lgarron/cubeflower/README.md

# Cubeflower

An elegant print-in-place cube box with a few useful features.

<https://www.youtube.com/shorts/GLqVjow3PYY>
Left and right lids of the cube flower folded mostly open, with the cube elevated in the middle

## Revisions

| Series | Features| Ease of printing |
|-|-|-|
| `v0.1.x` | Thicker walls, taller | Easy|
| `v0.2.x` | Thinner walls, minimal height | More challenging |

For now, consider printing [v0.1.6](https://github.com/lgarron/cubeflower/blob/v0.1.6/cube-box-v0.1.6.scad.3mf) before trying to print any `v0.2.x` version.

`v0.2.x` trades off carrying size for more reliance on material strength and printer tolerances. I personally get my best results with [Burgundy PLA-CF](https://us.store.bambulab.com/products/pla-cf) on a [Bambu Lab X1 Carbon](https://us.store.bambulab.com/products/x1-carbon).

Of the 0.2.x versions, [v0.2.14](https://github.com/lgarron/cubeflower/blob/v0.2.14/Cubeflower-Orchid-v0.2.14.scad) is currently the most battle-tested.

## License

Cubeflower is licensed under the [Attribution-NonCommercial-ShareAlike 4.0 International](https://creativecommons.org/licenses/by-nc-sa/4.0/deed.en) license. This means:

- You are welcome to print this design for yourself and your friends.
- You are not allowed to *sell* design or prints.
- You must make sure to attribute the design and share any changes you make to it.

Please [contact Lucas Garron](https://garron.net/) if you are interested in producing and selling Cubeflowers and we can probably come to an arrangement.
