lgarron/cubeflower/Cubeflower-Orchid-v0.2.15-61mm.scad

LID_OVEROPENED_FLAT_ANGLE = 1.45;

/*

# Bambu Studio config steps

- 0.4mm nozzle, 0.20mm strength
- Global → Support → Support
  - Enable support → yes
  - Type: `tree(auto)`
  - On build plate only → yes
  - Remove small overhangs → no
- Objects
  - Support blocker sub-object:
    - Change type → Support Blocker
  - Solid infill sub-object:
    - Change type → Modifier
    - Sparse infill density: 100% (allow the infill pattern to be changed to rectilinear automatically)

*/

/********/

DESIGN_VARIANT_TEXT = "ORCHID";
VERSION_TEXT = "v0.2.15";
// Avoid setting to 0 for printing unless you want overly shaved lids
OPENING_ANGLE_EACH_SIDE = 75; // Note: flat bottom is `90 + LID_OVEROPENED_FLAT_ANGLE`, flat inner lid is `90`
DEBUG = false;
INCLUDE_INNER_STAND_ENGRAVING = false;
PRINT_IN_PLACE = true;

INCLUDE_SOLID_INFILL_SHAPE = true;
INCLUDE_SUPPORT_BLOCKER_SHAPE = PRINT_IN_PLACE;

CUBE_EDGE_LENGTH = 61; // mm

INNER_STAND_ENGRAVING_FILE = "./archived/engraving/engraving.svg";

SET_ON_SIDE_FOR_PRINTING = !DEBUG && PRINT_IN_PLACE;

$fn = DEBUG ? 64 : 90;
LID_TOP_FN = DEBUG ? 64 : 360;

include <./node_modules/scad/duplicate.scad>
include <./node_modules/scad/minkowski_shell.scad>
include <./node_modules/scad/round_bevel.scad>
include <./node_modules/scad/small_hinge.scad>

/*

## v0.2.13

- Decrease hinge thickness to 6mm.

## v0.2.12

- Increase lat offset to add more tolerance for folding fully open.

## v0.2.11

- Set all symmetry shaving to 0.15mm.
- Increase hinge thickness to 7mm.

## v0.2.10

- Lower the version engravings back into the hinges at the right depth.

## v0.2.8

- Fix hinge tangent shaving for in-place printing.
- Adjust the support blocker the engraving so that it doesn't block the bottom of the inner plate for ≈90° hinge
printing.

## v0.2.7

- Fix calculations about the height taken up by gears.

## v0.2.6

- Allow lids to overextend their rotation so they can lay flat.

## v0.2.5

- Include solid infill shape.

## v0.2.4

- Add design variant engraving.
- Allow the inner stand to be printed separately.
- Adjust `difference(…)` calculations to work at 90 degrees.

## v0.2.3

- Move the inner stand clearance to the inside and increase to 0.25mm.
- Decrease engraving depth.
- Increase lat clearance for lower-friction end motion.
- Add a rounded bottom side to test push-down closing.
- Add thumb divots to the lid tops.

## v0.2.2

- Restore clearance for the inner stand.

## v0.2.1

- Fix 180° rotational symmetry for the hinge gears.

## v0.2.0

- Slim the gears to 5mm scale to decrease the box height.

## v0.1.6

- Make the hinge gears rotationally symmetrical to allow box bottoms to be stacked in either orientation.
- Shave hinge blocks and lids.
- Add version engraving.
- Add `SET_ON_SIDE_FOR_PRINTING` parameter.
- Add an optional inner stand engraving.

## v0.1.5

- Lower the shell for the stand.

## v0.1.4

(Abandoned.)

## v0.1.3

- Scale the cube edge length from 28mm to 56mm
- Scale clearances (including in hinge).
- Add a little extra clearance inside.

## v0.1.2

- Add lids

## v0.1.1

- Adjust clearances for vertical printing.

*/

HINGE_THICKNESS = 6;

DEFAULT_CLEARANCE = 0.1;
MAIN_CLEARANCE_SCALE = 0.5;
SLIDING_CLEARANCE = 0.2;

INNER_STAND_CLEARANCE = 0.25;

LARGE_VALUE = 200;

INNER_STAND_LIP_THICKNESS = 1.5;
INNER_STAND_LIP_HEIGHT = 8;
INNER_STAND_FLOOR_ELEVATION = INNER_STAND_LIP_THICKNESS;

ENGRAVING_LEVEL_DEPTH = 0.15;

LAT_WIDTH = 4;

OUTER_SHELL_THICKNESS = 1.5;

module main_cube()
{
    translate([ 0, 0, CUBE_EDGE_LENGTH / 2 ]) cube(CUBE_EDGE_LENGTH, center = true);
};
module main_cube_on_stand()
{
    translate([ 0, 0, INNER_STAND_FLOOR_ELEVATION ]) main_cube();
};

OUTER_SHELL_INNER_WIDTH = CUBE_EDGE_LENGTH + INNER_STAND_LIP_THICKNESS * 2;
OUTER_SHELL_OUTER_WIDTH = OUTER_SHELL_INNER_WIDTH + 2 * OUTER_SHELL_THICKNESS;

GEAR_MAX_RADIAL_DIVERGENCE = HINGE_THICKNESS / 2 * __SMALL_HINGE__MAX_RADIAL_DIVERGENCE_FACTOR;
BASE_HEIGHT = HINGE_THICKNESS + GEAR_MAX_RADIAL_DIVERGENCE;

HINGE_GEAR_OUTER_RADIUS = HINGE_THICKNESS / 2 + GEAR_MAX_RADIAL_DIVERGENCE;

BASE_LATTICE_OFFSET_MESHING_EXTRA = 0.2;

BASE_LATTICE_OFFSET = HINGE_THICKNESS + DEFAULT_CLEARANCE + BASE_LATTICE_OFFSET_MESHING_EXTRA;
BASE_LATTICE_COMPLEMENT_OFFSET = HINGE_THICKNESS;

module lat(i, mirror_scale)
{
    scale([ mirror_scale, 1, 1 ]) translate([
        -LARGE_VALUE / 2, i * LAT_WIDTH * 2 + LAT_WIDTH / 2 + mirror_scale * LAT_WIDTH / 2 - SLIDING_CLEARANCE,
        -BASE_HEIGHT - _EPSILON -
        LARGE_VALUE
    ])
        cube([
            LARGE_VALUE, LAT_WIDTH + SLIDING_CLEARANCE * 2,
            GEAR_MAX_RADIAL_DIVERGENCE * 2 + _EPSILON + DEFAULT_CLEARANCE +
            LARGE_VALUE
        ]);
}

module rotate_for_lid_right(angle)
{
    translate([ HINGE_THICKNESS / 2, 0, -HINGE_THICKNESS / 2 ]) rotate([ 0, angle, 0 ])
        translate([ -HINGE_THICKNESS / 2, 0, HINGE_THICKNESS / 2 ]) children();
}

module rotate_for_lid_left(angle)
{
    translate([ -HINGE_THICKNESS / 2, 0, -HINGE_THICKNESS / 2 ]) rotate([ 0, -angle, 0 ])
        translate([ HINGE_THICKNESS / 2, 0, HINGE_THICKNESS / 2 ]) children();
}

LATS_EACH_SIDE = 10; // TODO: computer from cube size

module right_lats()
{
    render() union()
    {
        for (i = [-LATS_EACH_SIDE:LATS_EACH_SIDE])
        {
            lat(i, 1);
        }
    }
}
module left_lats()
{
    render() union()
    {
        for (i = [-LATS_EACH_SIDE:LATS_EACH_SIDE])
        {
            lat(i, -1);
        }
    }
}

module debug_quarter_negative()
{
    if (DEBUG)
    {
        translate([ -LARGE_VALUE / 2, 0, 0 ]) cube(LARGE_VALUE, center = true); // TODO
        translate([ 0, -LARGE_VALUE / 2, 0 ]) cube(LARGE_VALUE, center = true); // TODO
    }
}

module lid_part(w, d, h, pre_angle_to_lie_flat_on_table = false)
{

    lid_radius_w = w - HINGE_THICKNESS / 2;
    lid_radius_h = h + INNER_STAND_FLOOR_ELEVATION + HINGE_THICKNESS / 2;
    lid_radius = sqrt(pow(lid_radius_w, 2) + pow(lid_radius_h, 2));

    difference()
    {
        rotate_for_lid_right(angle = pre_angle_to_lie_flat_on_table ? -LID_OVEROPENED_FLAT_ANGLE : 0) difference()
        {
            rotate_for_lid_right(angle = pre_angle_to_lie_flat_on_table ? LID_OVEROPENED_FLAT_ANGLE : 0)
                translate([ HINGE_THICKNESS / 2, 0, -HINGE_THICKNESS / 2 ]) rotate([ 90, 0, 0 ])
                    cylinder(h = d, r = lid_radius, center = true, $fn = LID_TOP_FN);
            translate([ LARGE_VALUE / 2 + w, 0, 0 ]) cube([ LARGE_VALUE, LARGE_VALUE, LARGE_VALUE ], center = true);
        }
        translate([ -LARGE_VALUE / 2 + HINGE_THICKNESS / 2, 0, 0 ])
            cube([ LARGE_VALUE, LARGE_VALUE, LARGE_VALUE ], center = true);
        translate([ 0, 0, -LARGE_VALUE / 2 + INNER_STAND_FLOOR_ELEVATION ])
            cube([ LARGE_VALUE, LARGE_VALUE, LARGE_VALUE ], center = true);
    }

    translate([ 0, -d / 2, INNER_STAND_FLOOR_ELEVATION ])
        cube([ HINGE_THICKNESS / 2, d, lid_radius - lid_radius_h + h ]);
}

VERSION_TEXT_ENGRAVING_DEPTH = 0.25;

module engraving_text(text_string, _epsilon, halign = "center")
{
    translate([ 0, 0, -VERSION_TEXT_ENGRAVING_DEPTH ]) linear_extrude(VERSION_TEXT_ENGRAVING_DEPTH + _epsilon)
        text(text_string, size = 2, font = "Ubuntu:style=bold", valign = "center", halign = halign);
}

BOTTOM_ROUNDING_RADIUS_X = 5;
BOTTOM_ROUNDING_RADIUS_Z = 12;

module bottom_rounding_negative()
{
    // TODO: make this work
    render() difference()
    {
        translate([
            OUTER_SHELL_INNER_WIDTH / 2 + OUTER_SHELL_THICKNESS - BOTTOM_ROUNDING_RADIUS_X,
            -(OUTER_SHELL_INNER_WIDTH + 2 * OUTER_SHELL_THICKNESS + 2 * _EPSILON) / 2, -BASE_HEIGHT -
            _EPSILON
        ])
            cube([
                BOTTOM_ROUNDING_RADIUS_X + _EPSILON, OUTER_SHELL_INNER_WIDTH + 2 * OUTER_SHELL_THICKNESS + 2 * _EPSILON,
                BOTTOM_ROUNDING_RADIUS_Z +
                _EPSILON
            ]);

        minkowski()
        {
            translate(
                [ OUTER_SHELL_INNER_WIDTH / 2, OUTER_SHELL_INNER_WIDTH / 2, -BASE_HEIGHT + OUTER_SHELL_THICKNESS ])
                scale([
                    1, 1,
                    (BOTTOM_ROUNDING_RADIUS_Z - OUTER_SHELL_THICKNESS) /
                        (BOTTOM_ROUNDING_RADIUS_X - OUTER_SHELL_THICKNESS)
                ]) rotate([ 90, -90, 0 ])
                    round_bevel_cylinder(OUTER_SHELL_INNER_WIDTH, BOTTOM_ROUNDING_RADIUS_X - OUTER_SHELL_THICKNESS);
            sphere(OUTER_SHELL_THICKNESS);
        }
    }

    translate([ 0, 0, -LARGE_VALUE / 2 - BASE_HEIGHT ]) cube(LARGE_VALUE, center = true);
}

THUMB_DIVOT_RADIUS = 20;
THUMB_DIVOT_DEPTH = 0.75;
THUMB_DIVOT_X = CUBE_EDGE_LENGTH * 0.35;
THUMB_DIVOT_Y = INNER_STAND_FLOOR_ELEVATION + CUBE_EDGE_LENGTH * 0.92;

HINGE_CONNECTOR_ALIGNMENT_EXTRA_HEIGHT = 0.4;
HINGE_CONNECTOR_ALIGNMENT_STUB_WIDTH = 5;

module hinge_connector(horizontal_clearance = 0, vertical_clearance = 0)
{
    difference()
    {
        duplicate_and_mirror([ 0, 1, 0 ]) translate([
            -HINGE_THICKNESS - horizontal_clearance, 10 + __SMALL_HINGE__PLUG_VERTICAL_CLEARANCE - horizontal_clearance,
            -HINGE_THICKNESS / 2
        ])
            cube([
                HINGE_THICKNESS * 2 - __SMALL_HINGE__CONNECTOR_OUTSIDE_CLEARANCE + 2 * horizontal_clearance,
                10 - 2 * __SMALL_HINGE__PLUG_VERTICAL_CLEARANCE + 2 * horizontal_clearance,
                HINGE_THICKNESS / 2 + INNER_STAND_CLEARANCE + HINGE_CONNECTOR_ALIGNMENT_EXTRA_HEIGHT +
                vertical_clearance
            ]);
        duplicate_and_mirror([ 0, 1, 0 ]) translate([
            -HINGE_CONNECTOR_ALIGNMENT_STUB_WIDTH / 2 + horizontal_clearance,
            15 + -HINGE_CONNECTOR_ALIGNMENT_STUB_WIDTH / 2 + horizontal_clearance,
            INNER_STAND_CLEARANCE
        ])
            cube([
                HINGE_CONNECTOR_ALIGNMENT_STUB_WIDTH - horizontal_clearance * 2,
                HINGE_CONNECTOR_ALIGNMENT_STUB_WIDTH - horizontal_clearance * 2,
                HINGE_CONNECTOR_ALIGNMENT_EXTRA_HEIGHT + vertical_clearance +
                _EPSILON
            ]);
    }
}

module inner_stand()
{

    render() difference()
    {
        render() difference()
        {
            minkowski()
            {
                main_cube();
                translate([ 0, 0, INNER_STAND_LIP_THICKNESS ])
                    sphere(INNER_STAND_LIP_THICKNESS - INNER_STAND_CLEARANCE);
            }

            main_cube_on_stand();
            translate([ 0, 0, LARGE_VALUE / 2 + INNER_STAND_FLOOR_ELEVATION + INNER_STAND_LIP_HEIGHT ])
                cube(LARGE_VALUE, center = true);

            if (!PRINT_IN_PLACE)
            {
                hinge_connector(horizontal_clearance = 0.05, vertical_clearance = 0.05);
            }
        }

        duplicate_and_mirror() duplicate_and_mirror([ 0, 1, 0 ])
            duplicate_and_translate([ 0, -OUTER_SHELL_INNER_WIDTH / 2, 0 ])
                translate([ HINGE_THICKNESS / 2, 0, -HINGE_THICKNESS / 2 ]) rotate([ -90, 0, 0 ]) difference()
        {
            cylinder(h = 10 - __SMALL_HINGE__GEAR_OFFSET_HEIGHT, r = HINGE_GEAR_OUTER_RADIUS);
            translate([ LARGE_VALUE / 2 + DEFAULT_CLEARANCE, 0, 0 ]) cube(LARGE_VALUE, center = true);
        }

        if (INCLUDE_INNER_STAND_ENGRAVING)
        {
            render() union()
            {
                render() translate([ 0, 0, INNER_STAND_FLOOR_ELEVATION + _EPSILON - ENGRAVING_LEVEL_DEPTH * 2 ])
                    linear_extrude(ENGRAVING_LEVEL_DEPTH * 2 + _EPSILON)
                        import(INNER_STAND_ENGRAVING_FILE, dpi = 25.4, center = true);
            }
        }

        debug_quarter_negative();
    }
}

module pre_lats_right()
{
    rotate_for_lid_right(LID_OVEROPENED_FLAT_ANGLE) difference()
    {
        rotate_for_lid_right(LID_OVEROPENED_FLAT_ANGLE) difference()
        {
            children();
            bottom_rounding_negative();
            translate([
                -LARGE_VALUE / 2 + BASE_LATTICE_OFFSET, 0, -LARGE_VALUE / 2 - BASE_HEIGHT +
                GEAR_MAX_RADIAL_DIVERGENCE
            ]) cube(LARGE_VALUE, center = true);
        }

        translate([ LARGE_VALUE / 2 + OUTER_SHELL_OUTER_WIDTH / 2, 0, 0 ]) cube(LARGE_VALUE, center = true);
    }
}

HINGE_LENGTH_COMPARISON = 57;

module duplicate_and_mirror_with_corresponding_lats_and_bottom_rounding_difference()
{
    rotate_for_lid_right(OPENING_ANGLE_EACH_SIDE - 2 * LID_OVEROPENED_FLAT_ANGLE) difference()
    {
        pre_lats_right() children();
        right_lats();
    }

    rotate_for_lid_left(OPENING_ANGLE_EACH_SIDE - 2 * LID_OVEROPENED_FLAT_ANGLE) difference()
    {
        mirror([ 1, 0, 0 ]) pre_lats_right() children();
        left_lats();
    }
}

module hinge_core_hinge(second = false)
{

    rotate([ 90, 0, 0 ]) translate([ 0, 0, second ? -30 : 0 ]) translate([ 0, -HINGE_THICKNESS, 0 ]) difference()
    {
        small_hinge_30mm(main_thickness = HINGE_THICKNESS, rotate_angle_each_side = OPENING_ANGLE_EACH_SIDE,
                         main_clearance_scale = 0.5, plug_clearance_scale = 1, round_far_side = true,
                         common_gear_offset = 0, extra_degrees = LID_OVEROPENED_FLAT_ANGLE, shave_end_tangents = true,
                         extend_block_ends = (CUBE_EDGE_LENGTH - HINGE_LENGTH_COMPARISON) / 2);

        translate([ 0, 0, (LARGE_VALUE / 2 + 30) * (second ? 1 : -1) ]) cube(LARGE_VALUE, center = true);
    }
}

module hinge_core()
{
    hinge_core_hinge(false);
    hinge_core_hinge(true);
}

module hinge()
{

    difference()
    {
        render() union()
        {
            duplicate_and_mirror_with_corresponding_lats_and_bottom_rounding_difference()
            {
                union()
                {
                    translate([ BASE_LATTICE_OFFSET, -OUTER_SHELL_INNER_WIDTH / 2, -BASE_HEIGHT ]) cube(
                        [ OUTER_SHELL_INNER_WIDTH / 2 - BASE_LATTICE_OFFSET, OUTER_SHELL_INNER_WIDTH, BASE_HEIGHT ]);

                    duplicate_and_mirror([ 0, 1, 0 ]) translate([ HINGE_THICKNESS - _EPSILON, 5 + 15, -BASE_HEIGHT ])
                        cube([
                            BASE_LATTICE_OFFSET - HINGE_THICKNESS + _EPSILON, OUTER_SHELL_INNER_WIDTH / 2 - 5 - 15,
                            BASE_HEIGHT
                        ]);
                    duplicate_and_mirror([ 0, 1, 0 ]) translate([ HINGE_THICKNESS, 0, -BASE_HEIGHT ])
                        cube([ BASE_LATTICE_OFFSET - HINGE_THICKNESS + _EPSILON, 10, BASE_HEIGHT ]);
                }
            }

            hinge_core();
        };
        translate([ 0, -15, -HINGE_THICKNESS + __SMALL_HINGE__CONNECTOR_OUTSIDE_CLEARANCE - _EPSILON ])
            rotate([ 180, 0, 0 ]) rotate([ 0, 0, 90 ]) resize([ 10 - 2, 0, VERSION_TEXT_ENGRAVING_DEPTH ], auto = true)
                engraving_text(VERSION_TEXT, 0);
        translate([ 0, 15, -HINGE_THICKNESS + __SMALL_HINGE__CONNECTOR_OUTSIDE_CLEARANCE - _EPSILON ])
            rotate([ 180, 0, 0 ]) rotate([ 0, 0, 90 ]) resize([ 10 - 2, 0, VERSION_TEXT_ENGRAVING_DEPTH ], auto = true)
                engraving_text(DESIGN_VARIANT_TEXT, 0);

        debug_quarter_negative();
    }
}

// TODO: this value is exact, but there's probably a neater way to make this calculation come from arithmetic with
// places.
DEFAULT_CLEARANCE_FACTOR_FOR_LID_SHAVE_TO_MATCH_LATS_AT_90_DEGREES = 3;

module lids()
{

    difference()
    {

        render() duplicate_and_mirror_with_corresponding_lats_and_bottom_rounding_difference() difference()
        {
            union()
            {
                render() minkowski_shell()
                {
                    union()
                    {
                        // lid_part(CUBE_EDGE_LENGTH / 2, CUBE_EDGE_LENGTH,
                        // CUBE_EDGE_LENGTH);
                        lid_part(OUTER_SHELL_INNER_WIDTH / 2, CUBE_EDGE_LENGTH, CUBE_EDGE_LENGTH,
                                 pre_angle_to_lie_flat_on_table = true);
                        lid_part(OUTER_SHELL_INNER_WIDTH / 2, CUBE_EDGE_LENGTH + INNER_STAND_LIP_THICKNESS * 2,
                                 INNER_STAND_LIP_HEIGHT);

                        translate([ 0, -OUTER_SHELL_INNER_WIDTH / 2, OUTER_SHELL_THICKNESS - BASE_HEIGHT ]) cube([
                            OUTER_SHELL_INNER_WIDTH / 2, OUTER_SHELL_INNER_WIDTH, BASE_HEIGHT +
                            INNER_STAND_FLOOR_ELEVATION
                        ]);
                    }

                    sphere(OUTER_SHELL_THICKNESS);
                }

                translate([ OUTER_SHELL_INNER_WIDTH / 2, OUTER_SHELL_INNER_WIDTH / 2, 0 ]) rotate([ 90, -90, 0 ])
                    round_bevel_complement(OUTER_SHELL_INNER_WIDTH, INNER_STAND_LIP_THICKNESS);
            }

            translate([ -LARGE_VALUE / 2, 0, 0 ]) cube([ LARGE_VALUE, LARGE_VALUE, LARGE_VALUE ], center = true);

            translate([
                -BASE_LATTICE_OFFSET, -(OUTER_SHELL_INNER_WIDTH + 2 * OUTER_SHELL_THICKNESS) / 2, -BASE_HEIGHT -
                _EPSILON
            ]) cube([ BASE_LATTICE_OFFSET * 2, OUTER_SHELL_OUTER_WIDTH, GEAR_MAX_RADIAL_DIVERGENCE + _EPSILON ]);
            translate([ -BASE_LATTICE_OFFSET, -(OUTER_SHELL_INNER_WIDTH) / 2, -BASE_HEIGHT - _EPSILON ])
                cube([ BASE_LATTICE_OFFSET * 2, OUTER_SHELL_INNER_WIDTH, BASE_HEIGHT + _EPSILON ]);

            translate([ 0, 0, -HINGE_THICKNESS ]) rotate([ 90, 0, 0 ])
                round_bevel_complement(height = OUTER_SHELL_INNER_WIDTH + 2 * OUTER_SHELL_THICKNESS + 2 * _EPSILON,
                                       radius = HINGE_THICKNESS / 2, center_z = true);

            duplicate_and_mirror([ 0, 1, 0 ]) translate([
                THUMB_DIVOT_X, -CUBE_EDGE_LENGTH / 2 - OUTER_SHELL_THICKNESS - THUMB_DIVOT_RADIUS + THUMB_DIVOT_DEPTH,
                THUMB_DIVOT_Y
            ]) sphere(THUMB_DIVOT_RADIUS);
        }

        translate([
            0, 0,
            LARGE_VALUE / 2 - BASE_LATTICE_COMPLEMENT_OFFSET -
                DEFAULT_CLEARANCE_FACTOR_FOR_LID_SHAVE_TO_MATCH_LATS_AT_90_DEGREES *
            DEFAULT_CLEARANCE
        ]) cube([ 2 * DEFAULT_CLEARANCE, LARGE_VALUE, LARGE_VALUE ], center = true);

        debug_quarter_negative();
    }
}

if (!PRINT_IN_PLACE)
{
    rotate([ SET_ON_SIDE_FOR_PRINTING ? -90 : 0, 0, 0 ]) union()
    {
        translate([ 0, PRINT_IN_PLACE ? 0 : (OUTER_SHELL_OUTER_WIDTH + 10), 0 ]) inner_stand();
    }
}

rotate([ SET_ON_SIDE_FOR_PRINTING ? -90 : 0, 0, 0 ]) union()
{
    if (DEBUG)
    {
        % main_cube_on_stand();
    }
    if (PRINT_IN_PLACE)
    {

        inner_stand();
    }
    hinge_connector();
    hinge();
    lids();
}

GEAR_SUPPORT_BLOCKER_EXTRA = 0.5;

if (INCLUDE_SOLID_INFILL_SHAPE && !DEBUG)
{
    rotate([ SET_ON_SIDE_FOR_PRINTING ? -90 : 0, 0, 0 ]) color("blue") union()
    {
        hinge_core();
        translate([ 0, 10, CUBE_EDGE_LENGTH * 1.25 ]) rotate([ 90, 0, 0 ]) linear_extrude(1)
            text("SOLID INFILL", size = 5, font = "Ubuntu:style=bold", valign = "center", halign = "center");
    }
}

if (INCLUDE_SUPPORT_BLOCKER_SHAPE && !DEBUG)
{
    rotate([ SET_ON_SIDE_FOR_PRINTING ? -90 : 0, 0, 0 ]) color("red") union()
    {
        // Gears
        translate([ 0, 0, -HINGE_THICKNESS / 2 - GEAR_SUPPORT_BLOCKER_EXTRA ]) cube(
            [
                HINGE_THICKNESS * 2 + 2 * GEAR_SUPPORT_BLOCKER_EXTRA, OUTER_SHELL_OUTER_WIDTH - _EPSILON * 2,
                HINGE_THICKNESS + 2 *
                GEAR_SUPPORT_BLOCKER_EXTRA
            ],
            center = true);
        // Engraving
        translate([ 0, 0, INNER_STAND_FLOOR_ELEVATION - INNER_STAND_CLEARANCE + _EPSILON ]) cube(
            [ OUTER_SHELL_INNER_WIDTH, OUTER_SHELL_INNER_WIDTH, INNER_STAND_FLOOR_ELEVATION - INNER_STAND_CLEARANCE ],
            center = true);

        translate([ 0, 0, CUBE_EDGE_LENGTH * 1.25 ]) rotate([ 90, 0, 0 ]) linear_extrude(1)
            text("SUPPORT BLOCKER", size = 5, font = "Ubuntu:style=bold", valign = "center", halign = "center");
    }
}
