lgarron/cubeflower/(list of files, cad)

Other CAD files:
Cubeflower-Orchid-v0.2.10.scad
Cubeflower-Orchid-v0.2.11.scad
Cubeflower-Orchid-v0.2.12.scad
Cubeflower-Orchid-v0.2.13.scad
Cubeflower-Orchid-v0.2.14.scad
Cubeflower-Orchid-v0.2.16.scad
Cubeflower-Orchid-v0.2.17.scad
Cubeflower-Orchid-v0.2.18.scad
Cubeflower-Orchid-v0.2.19.scad
Cubeflower-Orchid-v0.2.20.scad
Cubeflower-Orchid-v0.2.22.scad
Cubeflower-Orchid-v0.2.23.scad
Cubeflower-Orchid-v0.2.25.scad
Cubeflower-Orchid-v0.2.3.scad
Cubeflower-Orchid-v0.2.4.scad
Cubeflower-Orchid-v0.2.5.scad
Cubeflower-Orchid-v0.2.7.scad
cube-box-v0.1.0.scad
cube-box-v0.1.3.scad
cube-box-v0.1.4.scad
cube-box-v0.1.5.scad
cube-box-v0.1.6.scad
cube-box-v0.2.0.scad
cube-box-v0.2.1.scad
