lgarron/cubeflower/(commit log)

2024-11-16 v0.1.2
    Release notes:
    - Add lids
    [cube-box-v0.1.1.scad, cube-box-v0.1.1.scad.3mf, cube-box-v0.1.2.scad, cube-box-v0.1.2.scad.3mf]
2024-11-17 v0.1.3
    - Scale the cube edge length from 28mm to 56mm
    - Scale clearances (including in hinge).
    - Add a little extra clearance inside.
    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
    [cube-box-v0.1.2.scad, cube-box-v0.1.2.scad.3mf, cube-box-v0.1.3.scad, cube-box-v0.1.3.scad.3mf]
2024-11-18 v0.1.4
    - Lower the shell for the stand.
    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
    [cube-box-v0.1.3.scad.3mf, cube-box-v0.1.4.scad, cube-box-v0.1.4.scad.3mf, cube-box-v0.1.4.scad.tent.3mf]
2024-11-18 v0.1.3-75deg
    - Set the lid angles to 75 degrees for printing.
    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
    [cube-box-v0.1.3-75deg.scad, cube-box-v0.1.3-75deg.scad.3mf, cube-box-v0.1.3.scad.3mf]
2024-11-19 v0.1.5
    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
    [cube-box-v0.1.3-75deg.scad.3mf, cube-box-v0.1.5.scad]
2024-11-19 Set cube edge length to 57mm.
    [cube-box-v0.1.6.scad]
2024-11-21 Move TODOs out of the dev file.
    [cube-box-v0.1.6.scad]
2024-11-22 Fix gear symmetry and shaving.
    [cube-box-v0.1.6.scad]
2024-11-22 Reduce `BASE_EXTRA_HEIGHT_FOR_GEARS` to 0.5.
    [cube-box-v0.1.6.scad]
2024-11-22 Add version engraving.
    [cube-box-v0.1.6.scad]
2024-11-22 Refactor parameters.
    [cube-box-v0.1.6.scad]
2024-11-22 Add `SET_ON_SIDE_FOR_PRINTING` parameter.
    [cube-box-v0.1.6.scad]
2024-11-22 Add optional engraving.
    [cube-box-v0.1.6.scad]
2024-11-22 Fix a whole bunch of small dimensional issues.
    [cube-box-v0.1.6.scad]
2024-11-22 Decrease `INNER_STAND_BASE_THICKNESS`.
    [cube-box-v0.1.6.scad]
2024-11-22 v0.1.6
    - Make the hinge gears rotationally symmetrical to allow box bottoms to be stacked in either orientation.
    - Shave hinge blocks and lids.
    - Add version engraving.
    - Add `SET_ON_SIDE_FOR_PRINTING` parameter.
    - Add an optional inner stand engraving.
    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
2024-11-22 Slim the gears to 5mm scale to decrease the box height.
    [cube-box-v0.2.0.scad]
2024-11-22 Fix up engraving parameters.
    [cube-box-v0.2.0.scad]
2024-11-22 Fix gear size and clearance.
    [cube-box-v0.2.0.scad]
2024-11-22 Minimize height.
    [cube-box-v0.2.0.scad]
2024-11-22 Adjust engraving to a single level.
    [cube-box-v0.2.0.scad]
2024-11-22 Adjust stand connector `y` depths.
    [cube-box-v0.2.0.scad]
2024-11-22 v0.2.0
    - Scale the hinge and inner stand height to be as small as possible.
    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
    [cube-box-v0.2.0.scad.3mf]
2024-11-22 Fix 180° rotational symmetry for the hinge gears.
    [cube-box-v0.2.0.scad.3mf, cube-box-v0.2.1.scad]
2024-11-23 v0.2.1
    - Fix 180° rotational symmetry for the hinge gears.
    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
    [cube-box-v0.2.1.scad.3mf]
2024-11-23 Restore clearance for the inner stand.
    [cube-box-v0.2.1.scad.3mf, cube-box-v0.2.2.scad]
2024-11-23 v0.2.2
    - Restore clearance for the inner stand.
    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
    [cube-box-v0.2.2.scad.3mf]
2024-11-23 Decompose the main object `union(…)`.
    [cube-box-v0.2.2.scad.3mf, cube-box-v0.2.3.scad]
2024-11-23 Move the inner stand clearance to the inside and increase to 0.25mm.
    This also removes a single-layer bump when printing on the side.
    [cube-box-v0.2.3.scad]
2024-11-23 Decrease engraving depth.
    [cube-box-v0.2.3.scad]
2024-11-23 Increase lat clearance for lower-friction end motion.
    [cube-box-v0.2.3.scad]
2024-11-23 Add a rounded bottom side to test push-down closing.
    [cube-box-v0.2.3.scad]
2024-11-23 Fix bottom side rounding bevel.
    [cube-box-v0.2.3.scad]
2024-11-23 Consolidate most common parameters at the top.
    [cube-box-v0.2.3.scad]
2024-11-23 Add thumb divots to the lid tops.
    [cube-box-v0.2.3.scad]
2024-11-23 v0.2.3
    - Move the inner stand clearance to the inside and increase to 0.25mm.
    - Decrease engraving depth.
    - Increase lat clearance for lower-friction end motion.
    - Add a rounded bottom side to test push-down closing.
    - Add thumb divots to the lid tops.
    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
    [cube-box-v0.2.3.scad, cube-box-v0.2.3.scad.3mf]
2024-11-24 Add design variant engraving.
    [Cubeflower-Orchid-v0.2.3.scad.3mf, Cubeflower-Orchid-v0.2.4.scad]
2024-11-24 Add support blocker top-level object.
    [Cubeflower-Orchid-v0.2.4.scad]
2024-11-24 Allow the inner stand to be printed separately.
    [Cubeflower-Orchid-v0.2.4.scad]
2024-11-24 Adjust `difference(…)` calculations to work at 90 degrees.
    [Cubeflower-Orchid-v0.2.4.scad]
2024-11-24 Fix a `.3mf` rendering issue with floating lats.
    [Cubeflower-Orchid-v0.2.4.scad]
2024-11-24 Only set on side for print-in-place (for now).
    [Cubeflower-Orchid-v0.2.4.scad]
2024-11-24 v0.2.4
    - Add design variant engraving.
    - Allow the inner stand to be printed separately.
    - Adjust `difference(…)` calculations to work at 90 degrees.
    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
    [Cubeflower-Orchid-v0.2.4.scad.3mf]
2024-11-24 Include solid infill shape.
    [Cubeflower-Orchid-v0.2.4.scad.3mf, Cubeflower-Orchid-v0.2.5.scad]
2024-11-24 Update hinge.
    [Cubeflower-Orchid-v0.2.5.scad]
2024-11-24 Allow lid rotation to overextend so they can lay flat.
    [Cubeflower-Orchid-v0.2.6.scad]
2024-11-24 Make the main outer lid actually flat.
    [Cubeflower-Orchid-v0.2.6.scad]
2024-11-24 Bump engraved version.
    [Cubeflower-Orchid-v0.2.6.scad]
2024-11-24 v0.2.6
    - Allow lids to overextend their rotation so they can lay flat.
    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
    [Cubeflower-Orchid-v0.2.6.scad]
2024-11-24 Remove `MAIN_SCALE`.
    [Cubeflower-Orchid-v0.2.7.scad]
2024-11-24 Remove `INTERNAL_CUBE_EDGE_LENGTH`.
    [Cubeflower-Orchid-v0.2.7.scad]
2024-11-24 Fix radial divergence calculations.
    [Cubeflower-Orchid-v0.2.7.scad]
2024-11-24 v0.2.7
    - Fix calculations about the height taken up by gears.
    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
    [Cubeflower-Orchid-v0.2.7.scad]
2024-11-25 Fix hinge tangent shaving for in-place printing.
    [Cubeflower-Orchid-v0.2.8.scad]
2024-11-25 Adjust the support blocker the engraving so that it doesn't block the bottom of the inner plate for ≈90° hinge printing.
    [Cubeflower-Orchid-v0.2.8.scad]
2024-11-25 Try printing near-flat and without setting on its side.
    [Cubeflower-Orchid-v0.2.8.scad]
2024-11-25 v0.2.8
    - Fix hinge tangent shaving for in-place printing.
    - Adjust the support blocker the engraving so that it doesn't block the bottom of the inner plate for ≈90° hinge printing.
    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
2024-11-26 Bump to next dev version (v0.2.10-dev).
    [Cubeflower-Orchid-v0.2.10.scad, Cubeflower-Orchid-v0.2.8.scad]
2024-11-26 Lower the version engravings back into the hinges at the right depth.
    [Cubeflower-Orchid-v0.2.10.scad]
2024-11-26 Restore settings for best known printing results.
    [Cubeflower-Orchid-v0.2.10.scad]
2024-11-26 v0.2.10
    - Lower the version engravings back into the hinges at the right depth.
    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
2024-11-27 Bump to next dev version (v0.2.11).
    [Cubeflower-Orchid-v0.2.11.scad]
2024-11-27 Restore missing notes for v0.2.10.
    [Cubeflower-Orchid-v0.2.11.scad]
2024-11-27 Increase hinge thickness to 7mm.
    [Cubeflower-Orchid-v0.2.11.scad]
2024-11-27 Add missing note about shaving.
    [Cubeflower-Orchid-v0.2.11.scad]
2024-11-27 v0.2.11
    - Set all symmetry shaving to 0.15mm.
    - Increase hinge thickness to 7mm.
    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
    [Cubeflower-Orchid-v0.2.11.scad.3mf]
2024-11-27 Bump to next dev version (v0.2.12-dev).
    [Cubeflower-Orchid-v0.2.11.scad.3mf, Cubeflower-Orchid-v0.2.12.scad]
2024-11-28 Increase lat offset to add more tolerance for folding fully open.
    [Cubeflower-Orchid-v0.2.12.scad]
2024-11-28 Include Bambu config notes.
    [Cubeflower-Orchid-v0.2.12.scad]
2024-11-28 v0.2.12
    - Increase lat offset to add omre tolerance for folding fully open.
    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
    [Cubeflower-Orchid-v0.2.12.scad.3mf]
2024-11-28 Bump to next dev version (v0.2.13-dev).
    [Cubeflower-Orchid-v0.2.12.scad.3mf, Cubeflower-Orchid-v0.2.13.scad]
2024-11-28 Decrease hinge thickness to 6mm.
    [Cubeflower-Orchid-v0.2.13.scad]
2024-11-28 v0.2.13
    - Decrease hinge thickness to 6mm.
    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
    [Cubeflower-Orchid-v0.2.13.scad.3mf]
2024-11-28 Bump to next dev version (v0.2.14-dev).
    [Cubeflower-Orchid-v0.2.13.scad.3mf, Cubeflower-Orchid-v0.2.14.scad]
2024-11-29 Extend hinges to support any cube edge length.
    [Cubeflower-Orchid-v0.2.15.scad]
2024-11-29 v0.2.15
    - Extend hinges to support any cube edge length.
    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
    [Cubeflower-Orchid-v0.2.15.scad.3mf]
2024-11-29 Render with 61mm edge length.
    [Cubeflower-Orchid-v0.2.15.scad]
2024-11-29 v0.2.15-61mm
    - 61mm version.
    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
    [Cubeflower-Orchid-v0.2.15-61mm.scad, Cubeflower-Orchid-v0.2.15-61mm.scad.3mf, Cubeflower-Orchid-v0.2.15.scad.3mf]
2024-11-29 Bump to next dev version (v0.2.16-dev).
    [Cubeflower-Orchid-v0.2.15-61mm.scad.3mf, Cubeflower-Orchid-v0.2.16.scad]
2024-11-29 Restore edge length to 57mm.
    [Cubeflower-Orchid-v0.2.16.scad]
2024-11-30 Double `plug_clearance_scale` for materials that print with less accurate tolerances.
    [Cubeflower-Orchid-v0.2.16.scad]
2024-11-30 Refactor constants at the top of the file.
    [Cubeflower-Orchid-v0.2.16.scad]
2024-11-30 Increase `BASE_LATTICE_OFFSET_MESHING_EXTRA` to 0.5mm.
    [Cubeflower-Orchid-v0.2.16.scad]
2024-11-30 v0.2.16
    - Double `plug_clearance_scale` for materials that print with less accurate tolerances.
    - Increase `BASE_LATTICE_OFFSET_MESHING_EXTRA` to 0.5mm.
    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
    [Cubeflower-Orchid-v0.2.16.scad.3mf]
2024-12-01 Bump to next dev version (v0.2.17-dev).
    [Cubeflower-Orchid-v0.2.16.scad.3mf, Cubeflower-Orchid-v0.2.17.scad]
2024-12-01 Switch to printing the stand separately, with optional filled engraving.
    [Cubeflower-Orchid-v0.2.17.scad]
2024-12-01 v0.2.17
    - Switch to printing the stand separately, with optional filled engraving.
    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
2024-12-01 v0.2.17-corrected
    - Fix the support blocker position in the `.3mf`.
    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
    [Cubeflower-Orchid-v0.2.17.scad.3mf]
2024-12-01 Bump to next dev version (v0.2.18-dev).
    [Cubeflower-Orchid-v0.2.17.scad.3mf, Cubeflower-Orchid-v0.2.18.scad]
2024-12-01 Slice hinge connectors for debugging.
    [Cubeflower-Orchid-v0.2.18.scad]
2024-12-01 Add a stand plug.
    [Cubeflower-Orchid-v0.2.18.scad]
2024-12-01 Adjust inner stand plugs.
    [Cubeflower-Orchid-v0.2.18.scad]
2024-12-01 Adjust thumb divots to give more leverage for retraction.
    [Cubeflower-Orchid-v0.2.18.scad]
2024-12-01 Fix smoothness of inner stand plugs.
    [Cubeflower-Orchid-v0.2.18.scad]
2024-12-01 Tune stand plug head diameter and stem angle.
    [Cubeflower-Orchid-v0.2.18.scad]
2024-12-01 Adjust `BASE_LATTICE_OFFSET_MESHING_EXTRA`.
    [Cubeflower-Orchid-v0.2.18.scad]
2024-12-01 Fix connector `y` depth.
    [Cubeflower-Orchid-v0.2.18.scad]
2024-12-01 Fix the exact stand plug dimensions.
    [Cubeflower-Orchid-v0.2.18.scad]
2024-12-01 Fix the hinge connector `x` width.
    [Cubeflower-Orchid-v0.2.18.scad]
2024-12-02 Fix the inner stand alignment square clearance.
    [Cubeflower-Orchid-v0.2.18.scad]
2024-12-02 v0.2.18
    - Add inner stand plugs when printing the inner stand separately.
    - Adjust thumb divots to give more leverage for retraction.
    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
2024-12-02 Bump to next dev version (v0.2.19-dev).
    [Cubeflower-Orchid-v0.2.19.scad]
2024-12-02 Move thumb divots slightly apart.
    [Cubeflower-Orchid-v0.2.19.scad]
2024-12-02 Remove clearance between inner stand and connector.
    [Cubeflower-Orchid-v0.2.19.scad]
2024-12-02 Adjust inner stand plug.
    [Cubeflower-Orchid-v0.2.19.scad]
2024-12-02 Change `DEBUG` defaults.
    [Cubeflower-Orchid-v0.2.19.scad]
2024-12-02 Change printing angle to lie flat.
    [Cubeflower-Orchid-v0.2.19.scad]
2024-12-02 Color some pieces for debugging.
    [Cubeflower-Orchid-v0.2.19.scad]
2024-12-02 Change overopened angle to 0° for now.
    [Cubeflower-Orchid-v0.2.19.scad]
2024-12-02 Slant the lats where they touch near the hinge.
    [Cubeflower-Orchid-v0.2.19.scad]
2024-12-02 Widen the bottom rounding.
    [Cubeflower-Orchid-v0.2.19.scad]
2024-12-02 Add a note about changed stand plugs.
    [Cubeflower-Orchid-v0.2.19.scad]
2024-12-02 Lower the inner stand engraving level depth to one layer.
    [Cubeflower-Orchid-v0.2.19.scad]
2024-12-02 v0.2.19
    - Move thumb divots slightly apart.
    - Change overopened angle to 0° for now.
    - Slant the lats where they touch near the hinge.
    - Widen the bottom rounding.
    - Adjust inner stand plugs.
    - Lower the inner stand engraving level depth to one layer.
    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
2024-12-03 Bump to next dev version (v0.2.20-dev).
    [Cubeflower-Orchid-v0.2.20.scad]
2024-12-03 Adjust bottom rounding to avoid a very thin section.
    [Cubeflower-Orchid-v0.2.20.scad]
2024-12-03 Adjust plug head snugness.
    [Cubeflower-Orchid-v0.2.20.scad]
2024-12-04 Try printing the 1.45° overopening version at 45° open.
    [Cubeflower-Orchid-v0.2.20.scad]
2024-12-10 Bump to next dev version (v0.2.21-dev).
    [Cubeflower-Orchid-v0.2.21.scad]
2024-12-10 Give the lats more meshing space near the hinge.
    [Cubeflower-Orchid-v0.2.21.scad]
2024-12-10 Move design name and version engravings to the lids.
    [Cubeflower-Orchid-v0.2.21.scad]
2024-12-12 Snap connector test.
    [Cubeflower-Orchid-v0.2.21.scad, Cubeflower-Orchid-v0.2.21.scad.snap-connector-test.3mf]
2024-12-12 Add snap connectors to the top of the lid.
    [Cubeflower-Orchid-v0.2.21.scad, Cubeflower-Orchid-v0.2.21.scad.snap-connector-test.3mf]
2024-12-12 Add unsnapper helpers to the top lids.
    [Cubeflower-Orchid-v0.2.21.scad]
2024-12-12 v0.2.21
    - Give the lats more meshing space near the hinge.
    - Move design name and version engravings to the lids.
    - Add snap connectors to the top of the lid.
    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
2024-12-12 Bump to next dev version (v0.2.22-dev).
    [Cubeflower-Orchid-v0.2.21.scad, Cubeflower-Orchid-v0.2.22.scad]
2024-12-12 Reorder top-level objects to place the inner stand and its engraving next to each other at the end.
    [Cubeflower-Orchid-v0.2.22.scad]
2024-12-12 Add snap connectors to the sides.
    [Cubeflower-Orchid-v0.2.22.scad]
2024-12-12 Draft revisions for finger indentations.
    [Cubeflower-Orchid-v0.2.22.scad]
2024-12-12 Redesign the unsnappers into a flowerier shape.
    [Cubeflower-Orchid-v0.2.22.scad]
2024-12-12 Change to a single snap connector on top.
    [Cubeflower-Orchid-v0.2.22.scad]
2024-12-12 Add an `INCLUDE_UNSNAPPERS` option.
    [Cubeflower-Orchid-v0.2.22.scad]
2024-12-12 Change the lat slant to 22.5° to try to improve meshing.
    [Cubeflower-Orchid-v0.2.22.scad]
2024-12-12 v0.2.22
    - Redesign the unsnappers into a flowerier shape.
    - Change to a single snpa connector on top.
    - Change the lat slant to 22.5° to try to improve meshing.
    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
2024-12-13 Bump to next dev version (v0.2.23-dev).
    [Cubeflower-Orchid-v0.2.23.scad]
2024-12-13 Change `SNAP_CONNECTOR_ANGLE` to 30°.
    [Cubeflower-Orchid-v0.2.23.scad]
2024-12-13 Try a simple centered circle unsnapper.
    [Cubeflower-Orchid-v0.2.23.scad]
2024-12-13 Give the hinge gears a little extra rotational clearance in the inner stand.
    [Cubeflower-Orchid-v0.2.23.scad]
2024-12-13 Call `render()` in `snap_connector_negative()`.
    [Cubeflower-Orchid-v0.2.23.scad]
2024-12-13 Give the hinge connector a little extra bottom clearance to compensate for inaccuracy from small tree supports.
    [Cubeflower-Orchid-v0.2.23.scad]
2024-12-14 v0.2.23
    - Change `SNAP_CONNECTOR_ANGLE` to 30°.
    - Try a simple centered circle unsnapper.
    - Give the hinge gears a little extra rotational clearance in the inner stand.
    - Give the hinge connector a little extra bottom clearance to compensate for inaccuracy from small tree supports.
    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
2024-12-14 Bump to next dev version (v0.2.24-dev).
    [Cubeflower-Orchid-v0.2.24.scad]
2024-12-14 Return to two top snap connectors and adjust side snap connector angles.
    [Cubeflower-Orchid-v0.2.24.scad]
2024-12-14 v0.2.24
    - Change back from one to two snap connectors on top (and make the unsnapper a bit smaller to accommodate).
    - Change side snap connectors to 20°.
    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
2024-12-14 Bump to next dev version (v0.2.25-dev).
    [Cubeflower-Orchid-v0.2.24.scad, Cubeflower-Orchid-v0.2.25.scad]
2025-03-14 Bump to next dev version (v0.2.26-dev).
    [Cubeflower-Orchid-v0.2.26.scad]
2025-03-14 Add a note about skipping v0.2.25.
    [Cubeflower-Orchid-v0.2.26.scad]
2025-03-15 Add a side engraving.
    [Cubeflower-Orchid-v0.2.26.scad]
2025-03-15 Adjust side engraving size.
    [Cubeflower-Orchid-v0.2.26.scad]
2025-03-15 Add top text.
    [Cubeflower-Orchid-v0.2.26.scad]
2025-03-15 Use `INCLUDE_SIDE_ENGRAVING` and add `INCLUDE_TOP_TEXT`.
    [Cubeflower-Orchid-v0.2.26.scad]
2025-03-15 Support different top text on left and right.
    [Cubeflower-Orchid-v0.2.26.scad]
